the78mole/mppt-2420-hc/kicad/can.kicad_sch

## KiCad design kicad/can.kicad_sch (2025-12-03)

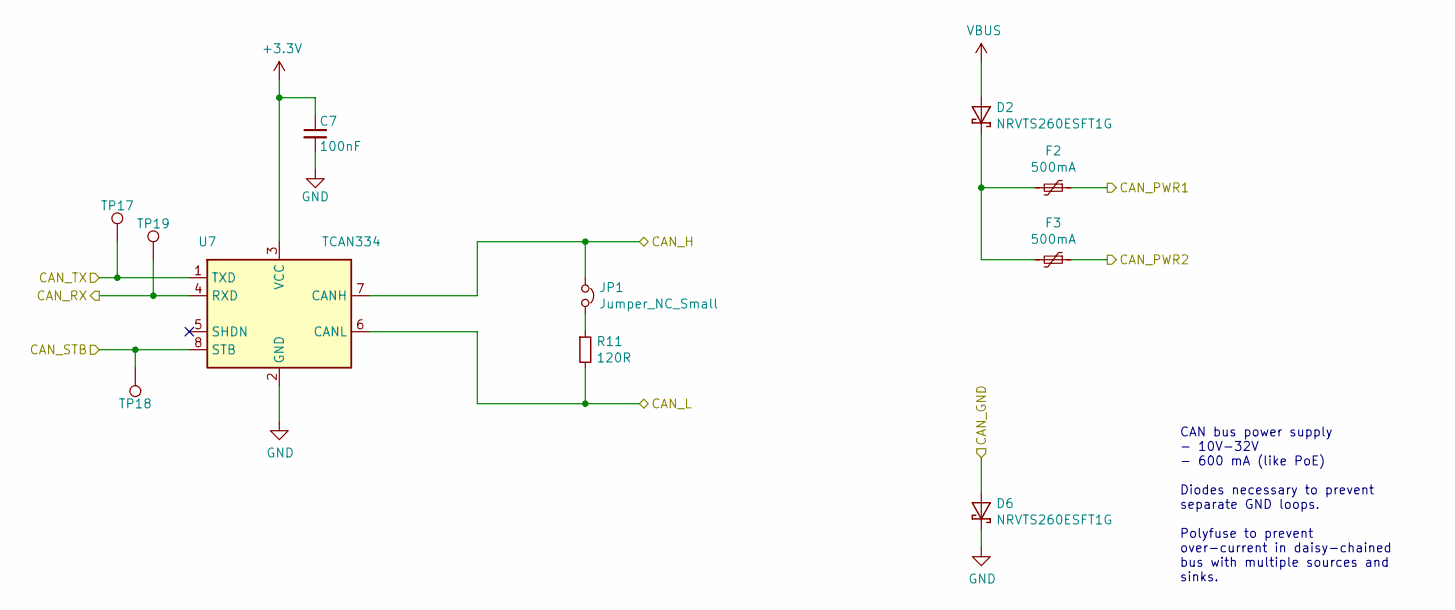
[picture p1: schematic can.kicad_sch]

Parts:
C7: 100nF; C_0603_1608
D2, D6: NRVTS260ESFT1G; D_SOD-123; PartNumber NRVTS260ESFT1G
F2, F3: 500mA; Fuse_1206_3216Metric; PartNumber 0ZCJ0050AF2E
JP1: Jumper_NC_Small; PinHeader_1x02_P2.54mm_Vertical
R11: 120R; R_1206_3216
TP17, TP18, TP19: 1.5mm; TestPoint_Pad_D1.5mm
U7: TCAN334; SOIC-8_3.9x4.9mm_Pitch1.27mm; PartNumber TCAN334DR

Connections:
+3.3V: C7.1, U7.3 (VCC)
CAN_GND: D6.2 (A)
CAN_H: JP1.1, U7.7 (CANH)
CAN_L: R11.2, U7.6 (CANL)
CAN_PWR1: F2.1
CAN_PWR2: F3.1
CAN_RX: TP19.1, U7.4 (RXD)
CAN_STB: TP18.1, U7.8 (STB)
CAN_TX: TP17.1, U7.1 (TXD)
GND: C7.2, D6.1 (K), U7.2 (GND)
unnamed: D2.1 (K), F2.2, F3.2
unnamed: JP1.2, R11.1
VBUS: D2.2 (A)

Notes on the sheet:
CAN bus power supply - 10V-32V - 600 mA (like PoE) Diodes necessary to prevent separate GND loops. Polyfuse to prevent over-current in daisy-chained bus with multiple sources and sinks.
