the78mole/mppt-2420-hc/kicad/dcdc.kicad_sch

## KiCad design kicad/dcdc.kicad_sch (2025-12-03)

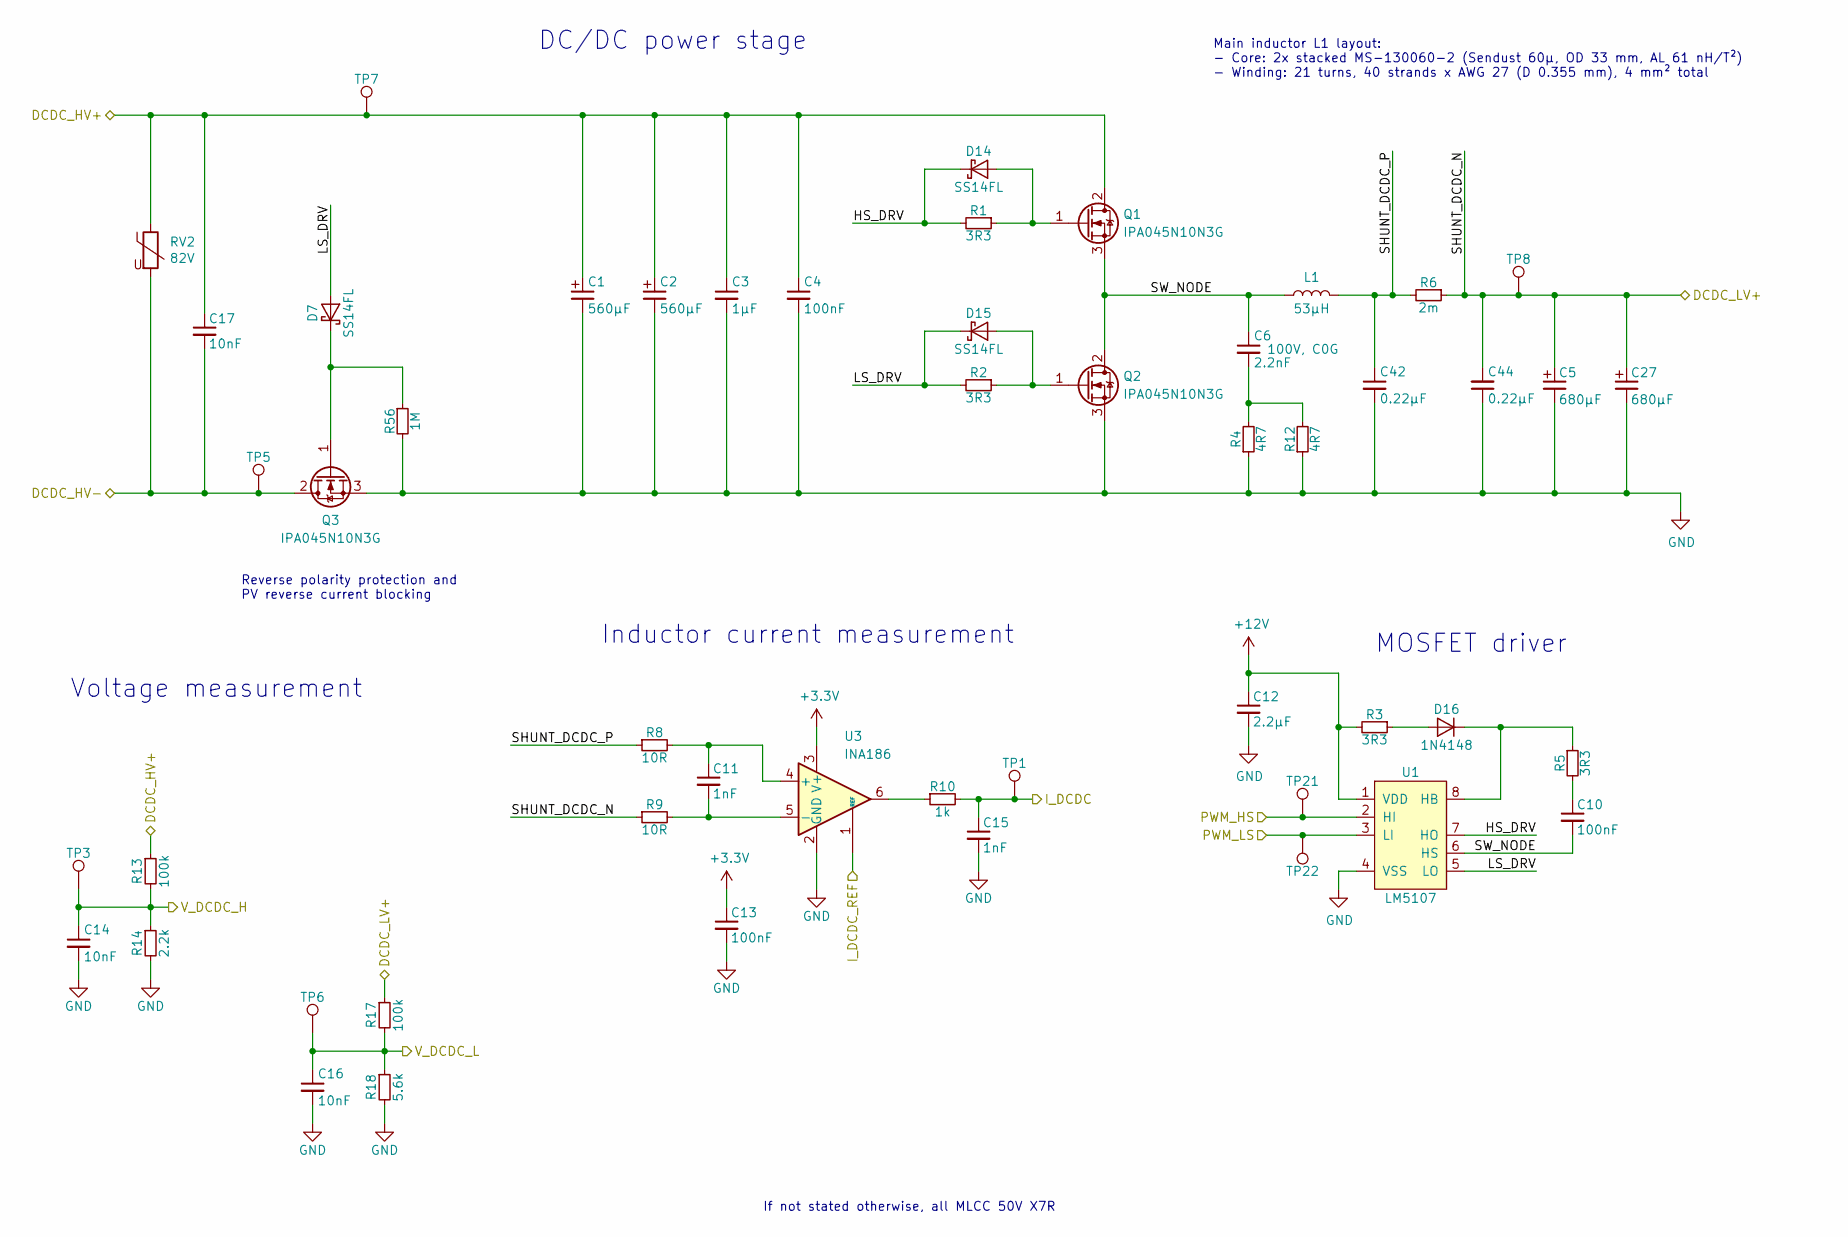
[picture p2: schematic dcdc.kicad_sch]

Parts:
C1, C2: 560µF; CP_Radial_D18.0mm_P7.50mm; PartNumber EKZN101ELL561MM25S
C3: 1µF; C_0805_2012
C4: 100nF; C_0805_2012
C5, C27: 680µF; CP_Radial_D10.0mm_P5.00mm; PartNumber EEU-FR1V681
C6: 2.2nF; C_0603_1608
C10, C13: 100nF; C_0603_1608
C11, C15: 1nF; C_0603_1608
C12: 2.2µF; C_0603_1608
C14, C16, C17: 10nF; C_0603_1608
C42, C44: 0.22µF; C_Rect_L7.2mm_W3.5mm_P5.00mm_FKS2_FKP2_MKS2_MKP2; PartNumber B32529C224J
D7, D14, D15: SS14FL; D_SOD-123; PartNumber SS14FL
D16: 1N4148; D_SOD-123; PartNumber 1N4148W-7-F
L1: 53µH; Inductor_Toroid_D32.8mm_4mm2
Q1, Q2, Q3: IPA045N10N3G; TO-220-3_Horizontal_BottomHeatsink; PartNumber IPA045N10N3G
R1, R2, R3, R5: 3R3; R_0805_2012; PartNumber RC0805FR-073R3L
R4, R12: 4R7; R_1206_3216; PartNumber RC1206FR-074R7L
R6: 2m; R_Bourns_CRE2512; PartNumber CRE2512-FZ-R002E-3
R8, R9: 10R; R_0603_1608
R10: 1k; R_0603_1608
R13, R17: 100k; R_0603_1608
R14: 2.2k; R_0603_1608
R18: 5.6k; R_0603_1608
R56: 1M; R_0603_1608
RV2: 82V; RV_Disc_D12mm_W4.3mm_P7.5mm; PartNumber MOV-10D820K
TP1, TP3, TP5, TP6, TP7, TP8, TP21, TP22: 1.5mm; TestPoint_Pad_D1.5mm
U1: LM5107; SOIC-8_3.9x4.9mm_Pitch1.27mm; PartNumber LM5107MAX/NOPB
U3: INA186; SOT-363_SC-70-6; PartNumber INA186A1IDCKR

Connections:
+3.3V: C13.1, U3.3 (V+)
+12V: C12.1, R3.2, U1.1 (VDD)
DCDC_HV+: C1.1, C2.1, C3.1, C4.1, C17.1, Q1.2 (D), R13.1, RV2.1, TP7.1
DCDC_HV-: C17.2, Q3.2 (D), RV2.2, TP5.1
DCDC_LV+: C5.1, C27.1, C44.2, R6.1, R9.1, R17.1, TP8.1
GND: C1.2, C2.2, C3.2, C4.2, C5.2, C12.2, C13.2, C14.2, C15.2, C16.2, C27.2, C42.2, C44.1, Q2.3 (S), Q3.3 (S), R4.1, R12.1, R14.2, R18.2, R56.2, U1.4 (VSS), U3.2 (GND)
HS_DRV: D14.1 (K), R1.2, U1.7 (HO)
I_DCDC: C15.1, R10.2, TP1.1
I_DCDC_REF: U3.1 (REF)
LS_DRV: D7.2 (A), D15.1 (K), R2.2, U1.5 (LO)
unnamed: C6.2, R4.2, R12.2
unnamed: C10.1, R5.2
unnamed: C11.1, R8.2, U3.4 (+)
unnamed: C11.2, R9.2, U3.5 (-)
unnamed: D7.1 (K), Q3.1 (G), R56.1
unnamed: D14.2 (A), Q1.1 (G), R1.1
unnamed: D15.2 (A), Q2.1 (G), R2.1
unnamed: D16.1 (K), R5.1, U1.8 (HB)
unnamed: D16.2 (A), R3.1
unnamed: R10.1, U3.6
PWM_HS: TP21.1, U1.2 (HI)
PWM_LS: TP22.1, U1.3 (LI)
SHUNT_DCDC_P: C42.1, L1.2, R6.2, R8.1
SW_NODE: C6.1, C10.2, L1.1, Q1.3 (S), Q2.2 (D), U1.6 (HS)
V_DCDC_H: C14.1, R13.2, R14.1, TP3.1
V_DCDC_L: C16.1, R17.2, R18.1, TP6.1

Notes on the sheet:
Main inductor L1 layout: - Core: 2x stacked MS-130060-2 (Sendust 60µ, OD 33 mm, AL 61 nH/T²) - Winding: 21 turns, 40 strands x AWG 27 (D 0.355 mm), 4 mm² total
Reverse polarity protection and PV reverse current blocking
Inductor current measurement
Voltage measurement
MOSFET driver
If not stated otherwise, all MLCC 50V X7R
DC/DC power stage
