the78mole/mppt-2420-hc/kicad/load-switch.kicad_sch

## KiCad design kicad/load-switch.kicad_sch (2025-12-03)

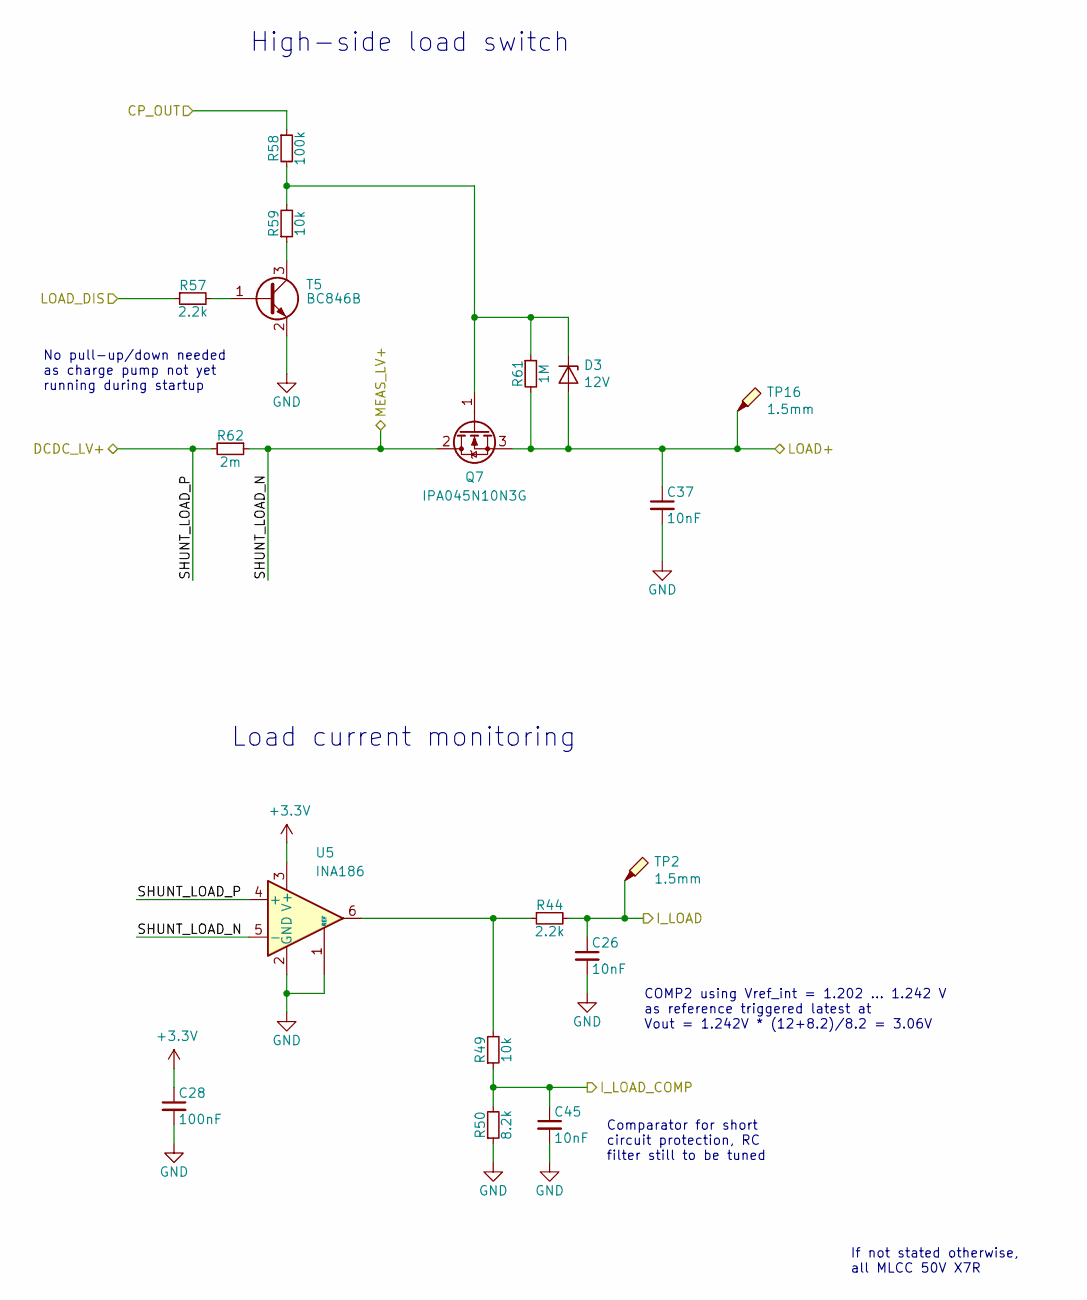
[picture p3: schematic load-switch.kicad_sch]

Parts:
C26, C37, C45: 10nF; C_0603_1608
C28: 100nF; C_0603_1608
D3: 12V; D_SOT-23_ANK; PartNumber SZBZX84C12LT3G
Q7: IPA045N10N3G; TO-220-3_Horizontal_BottomHeatsink; PartNumber IPA045N10N3G
R44, R57: 2.2k; R_0603_1608
R49, R59: 10k; R_0603_1608
R50: 8.2k; C_0603_1608
R58: 100k; R_0603_1608
R61: 1M; R_0603_1608
R62: 2m; R_Bourns_CRE2512; PartNumber CRE2512-FZ-R002E-3
T5: BC846B; SOT-23; PartNumber BC846BLT1G
TP2, TP16: 1.5mm; TestPoint_Pad_D1.5mm
U5: INA186; SOT-363_SC-70-6; PartNumber INA186A1IDCKR

Connections:
+3.3V: C28.1, U5.3 (V+)
CP_OUT: R58.1
DCDC_LV+: R62.2, U5.4 (+)
GND: C26.2, C28.2, C37.2, C45.2, R50.1, T5.2 (E), U5.1 (REF), U5.2 (GND)
I_LOAD: C26.1, R44.2, TP2.1
I_LOAD_COMP: C45.1, R49.1, R50.2
LOAD+: C37.1, D3.2 (A), Q7.3 (S), R61.2, TP16.1
LOAD_DIS: R57.1
MEAS_LV+: Q7.2 (D), R62.1, U5.5 (-)
unnamed: D3.1 (K), Q7.1 (G), R58.2, R59.2, R61.1
unnamed: R44.1, R49.2, U5.6
unnamed: R57.2, T5.1 (B)
unnamed: R59.1, T5.3 (C)

Notes on the sheet:
Comparator for short circuit protection, RC filter still to be tuned
Load current monitoring
No pull-up/down needed as charge pump not yet running during startup
High-side load switch
COMP2 using Vref_int = 1.202 ... 1.242 V as reference triggered latest at Vout = 1.242V * (12+8.2)/8.2 = 3.06V
If not stated otherwise, all MLCC 50V X7R
