the78mole/mppt-2420-hc/kicad/mcu.kicad_sch

## KiCad design kicad/mcu.kicad_sch (2025-12-03)

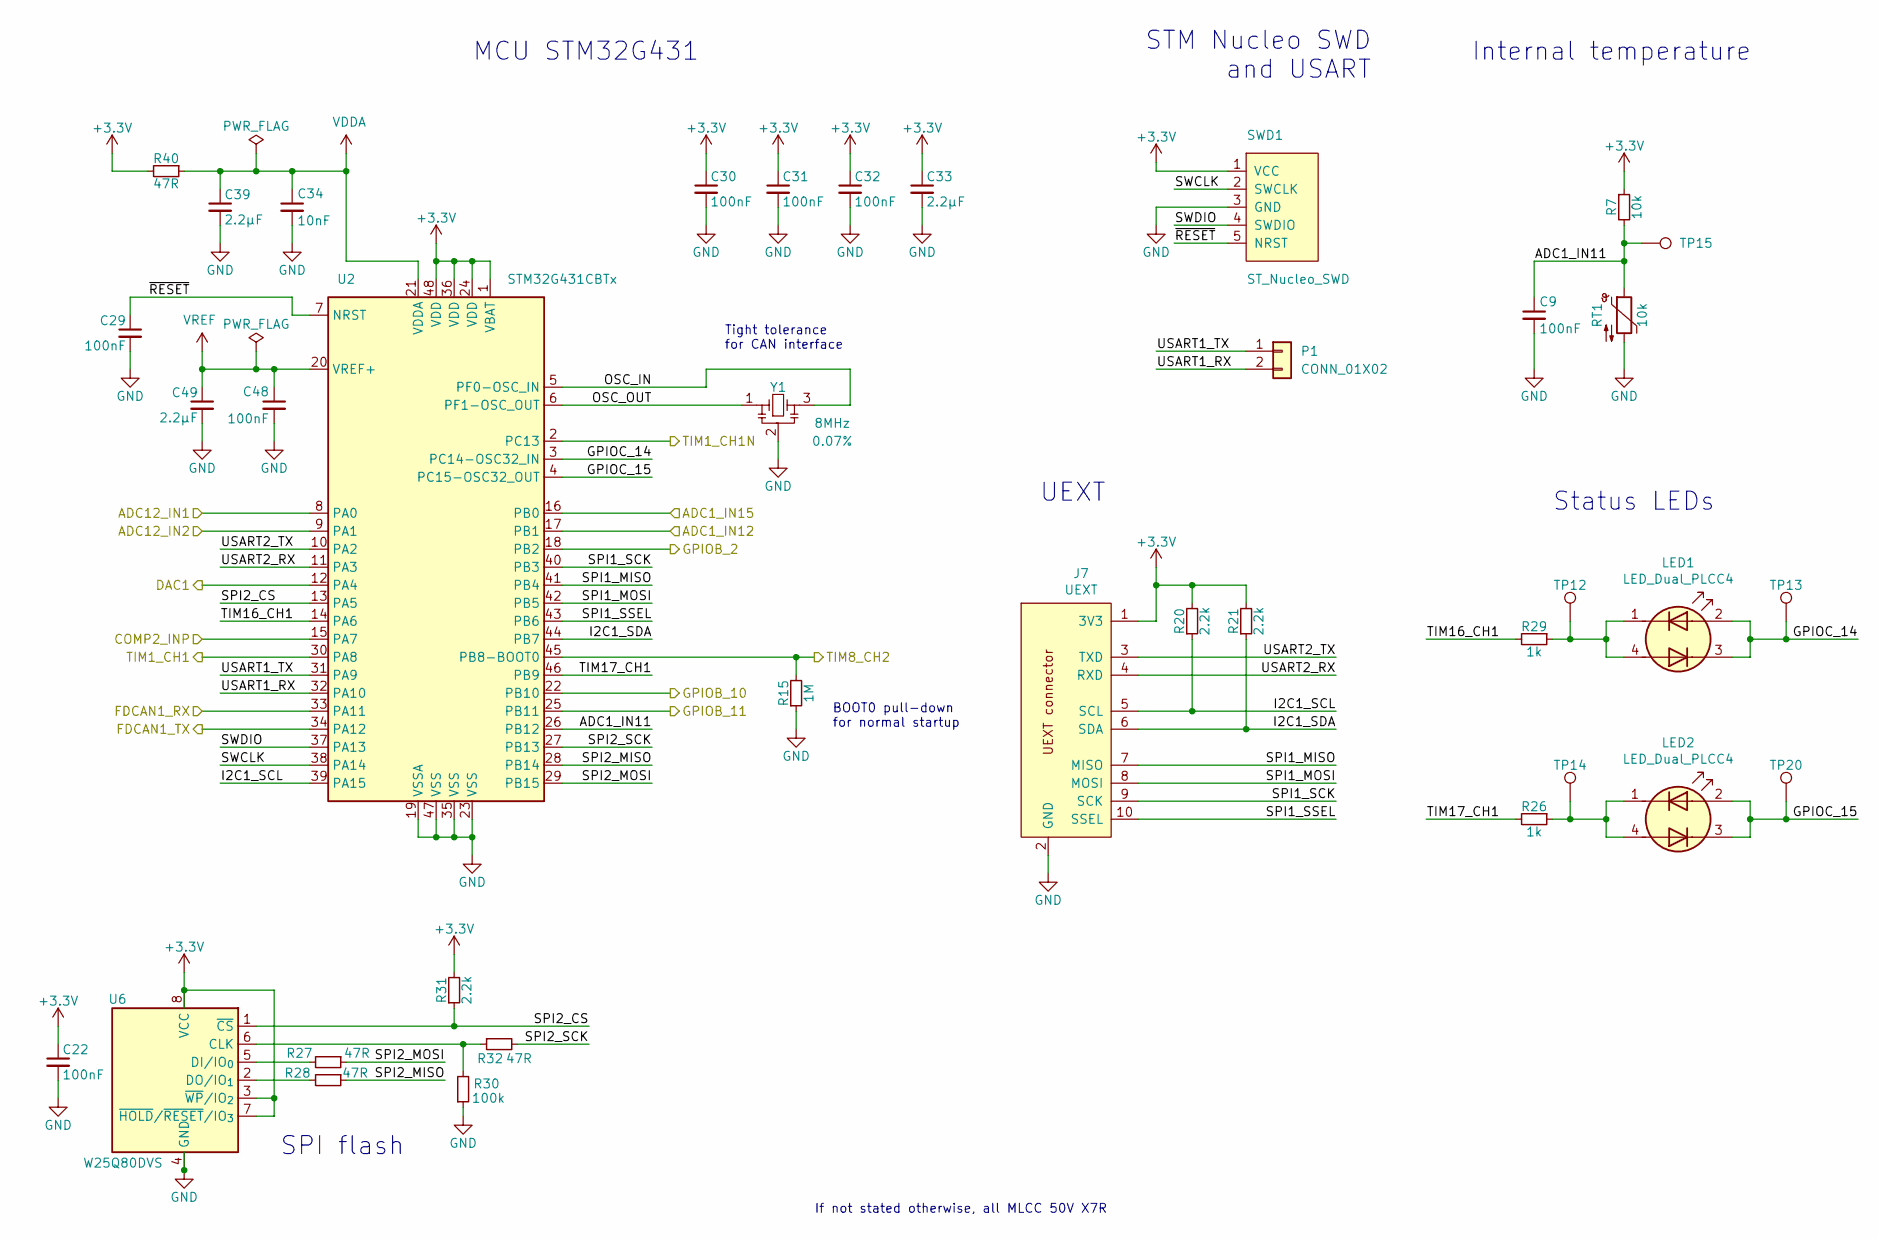
[picture p4: schematic mcu.kicad_sch]

Parts:
C9, C22, C29, C30, C31, C32, C48: 100nF; C_0603_1608
C33, C39, C49: 2.2µF; C_0603_1608
C34: 10nF; C_0603_1608
J7: UEXT; Box_Header_2x05x2.54mm_Straight; PartNumber Box header 2x5, 2.54mm pitch
LED1, LED2: LED_Dual_PLCC4; LED_Avago_PLCC4_3.2x2.8mm_CW; PartNumber LTST-E682KRKGWT
P1: CONN_01X02; PinHeader_1x02_P2.54mm_Vertical; PartNumber Pin header 1x5, 2.54mm pitch
R7: 10k; R_0603_1608
R15: 1M; R_0603_1608
R20, R21, R31: 2.2k; R_0603_1608
R26, R29: 1k; R_0603_1608
R27, R28, R32, R40: 47R; R_0603_1608
R30: 100k; R_0603_1608
RT1: 10k; C_Disc_D3.8mm_W2.6mm_P2.50mm; PartNumber NTCG163JF103FT1S
SWD1: ST_Nucleo_SWD; PinHeader_1x05_P2.54mm_Vertical; PartNumber Pin header 1x5, 2.54mm pitch
TP12, TP13, TP14, TP15, TP20: 1.5mm; TestPoint_Pad_D1.5mm
U2: STM32G431CBTx; LQFP-48_7x7mm_P0.5mm; PartNumber STM32G431CBT6
U6: W25Q80DVS; SOIC-8_3.9x4.9mm_Pitch1.27mm; PartNumber W25Q80DVSNIG
Y1: 8MHz; Resonator_Murata_CSTNE; PartNumber CSTNE8M00GH5C000R0

Connections:
+3.3V: C22.1, C30.1, C31.1, C32.1, C33.1, J7.1 (3V3), R7.1, R20.2, R21.2, R31.2, R40.2, SWD1.1 (VCC), U2.1 (VBAT), U2.24 (VDD), U2.36 (VDD), U2.48 (VDD), U6.3 (~WP/IO_{2}), U6.7 (~HOLD/~RESET/IO_{3}), U6.8 (VCC)
ADC1_IN11: C9.1, R7.2, RT1.1, TP15.1, U2.26 (PB12)
ADC1_IN12: U2.17 (PB1)
ADC1_IN15: U2.16 (PB0)
ADC12_IN1: U2.8 (PA0)
ADC12_IN2: U2.9 (PA1)
COMP2_INP: U2.15 (PA7)
DAC1: U2.12 (PA4)
FDCAN1_RX: U2.33 (PA11)
FDCAN1_TX: U2.34 (PA12)
GND: C9.2, C22.2, C29.2, C30.2, C31.2, C32.2, C33.2, C34.2, C39.2, C48.2, C49.2, J7.2 (GND), R15.1, R30.1, RT1.2, SWD1.3 (GND), U2.19 (VSSA), U2.23 (VSS), U2.35 (VSS), U2.47 (VSS), U6.4 (GND), Y1.2
GPIOB_2: U2.18 (PB2)
GPIOB_10: U2.22 (PB10)
GPIOB_11: U2.25 (PB11)
GPIOC_14: LED1.2 (K1), LED1.3 (A2), TP13.1, U2.3 (PC14-OSC32_IN)
GPIOC_15: LED2.2 (K1), LED2.3 (A2), TP20.1, U2.4 (PC15-OSC32_OUT)
I2C1_SCL: J7.5 (SCL), R20.1, U2.39 (PA15)
I2C1_SDA: J7.6 (SDA), R21.1, U2.44 (PB7)
unnamed: LED1.1 (A1), LED1.4 (K2), R29.1, TP12.1
unnamed: LED2.1 (A1), LED2.4 (K2), R26.1, TP14.1
unnamed: R27.2, U6.5 (DI/IO_{0})
unnamed: R28.2, U6.2 (DO/IO_{1})
unnamed: R30.2, R32.1, U6.6 (CLK)
OSC_IN: U2.5 (PF0-OSC_IN), Y1.3
OSC_OUT: U2.6 (PF1-OSC_OUT), Y1.1
SPI1_MISO: J7.7 (MISO), U2.41 (PB4)
SPI1_MOSI: J7.8 (MOSI), U2.42 (PB5)
SPI1_SCK: J7.9 (SCK), U2.40 (PB3)
SPI1_SSEL: J7.10 (SSEL), U2.43 (PB6)
SPI2_CS: R31.1, U2.13 (PA5), U6.1 (~CS)
SPI2_MISO: R28.1, U2.28 (PB14)
SPI2_MOSI: R27.1, U2.29 (PB15)
SPI2_SCK: R32.2, U2.27 (PB13)
SWCLK: SWD1.2 (SWCLK), U2.38 (PA14)
SWDIO: SWD1.4 (SWDIO), U2.37 (PA13)
TIM1_CH1: U2.30 (PA8)
TIM1_CH1N: U2.2 (PC13)
TIM8_CH2: R15.2, U2.45 (PB8-BOOT0)
TIM16_CH1: R29.2, U2.14 (PA6)
TIM17_CH1: R26.2, U2.46 (PB9)
USART1_RX: P1.2, U2.32 (PA10)
USART1_TX: P1.1, U2.31 (PA9)
USART2_RX: J7.4 (RXD), U2.11 (PA3)
USART2_TX: J7.3 (TXD), U2.10 (PA2)
VDDA: C34.1, C39.1, R40.1, U2.21 (VDDA)
VREF: C48.1, C49.1, U2.20 (VREF+)
~RESET: C29.1, SWD1.5 (NRST), U2.7 (NRST)

Notes on the sheet:
MCU STM32G431
BOOT0 pull-down for normal startup
Tight tolerance for CAN interface
UEXT
SPI flash
If not stated otherwise, all MLCC 50V X7R
Status LEDs
Internal temperature
STM Nucleo SWD and USART
