the78mole/mppt-2420-hc/kicad/mppt-2420-hc.kicad_sch

## KiCad design kicad/mppt-2420-hc.kicad_sch (2025-12-03)

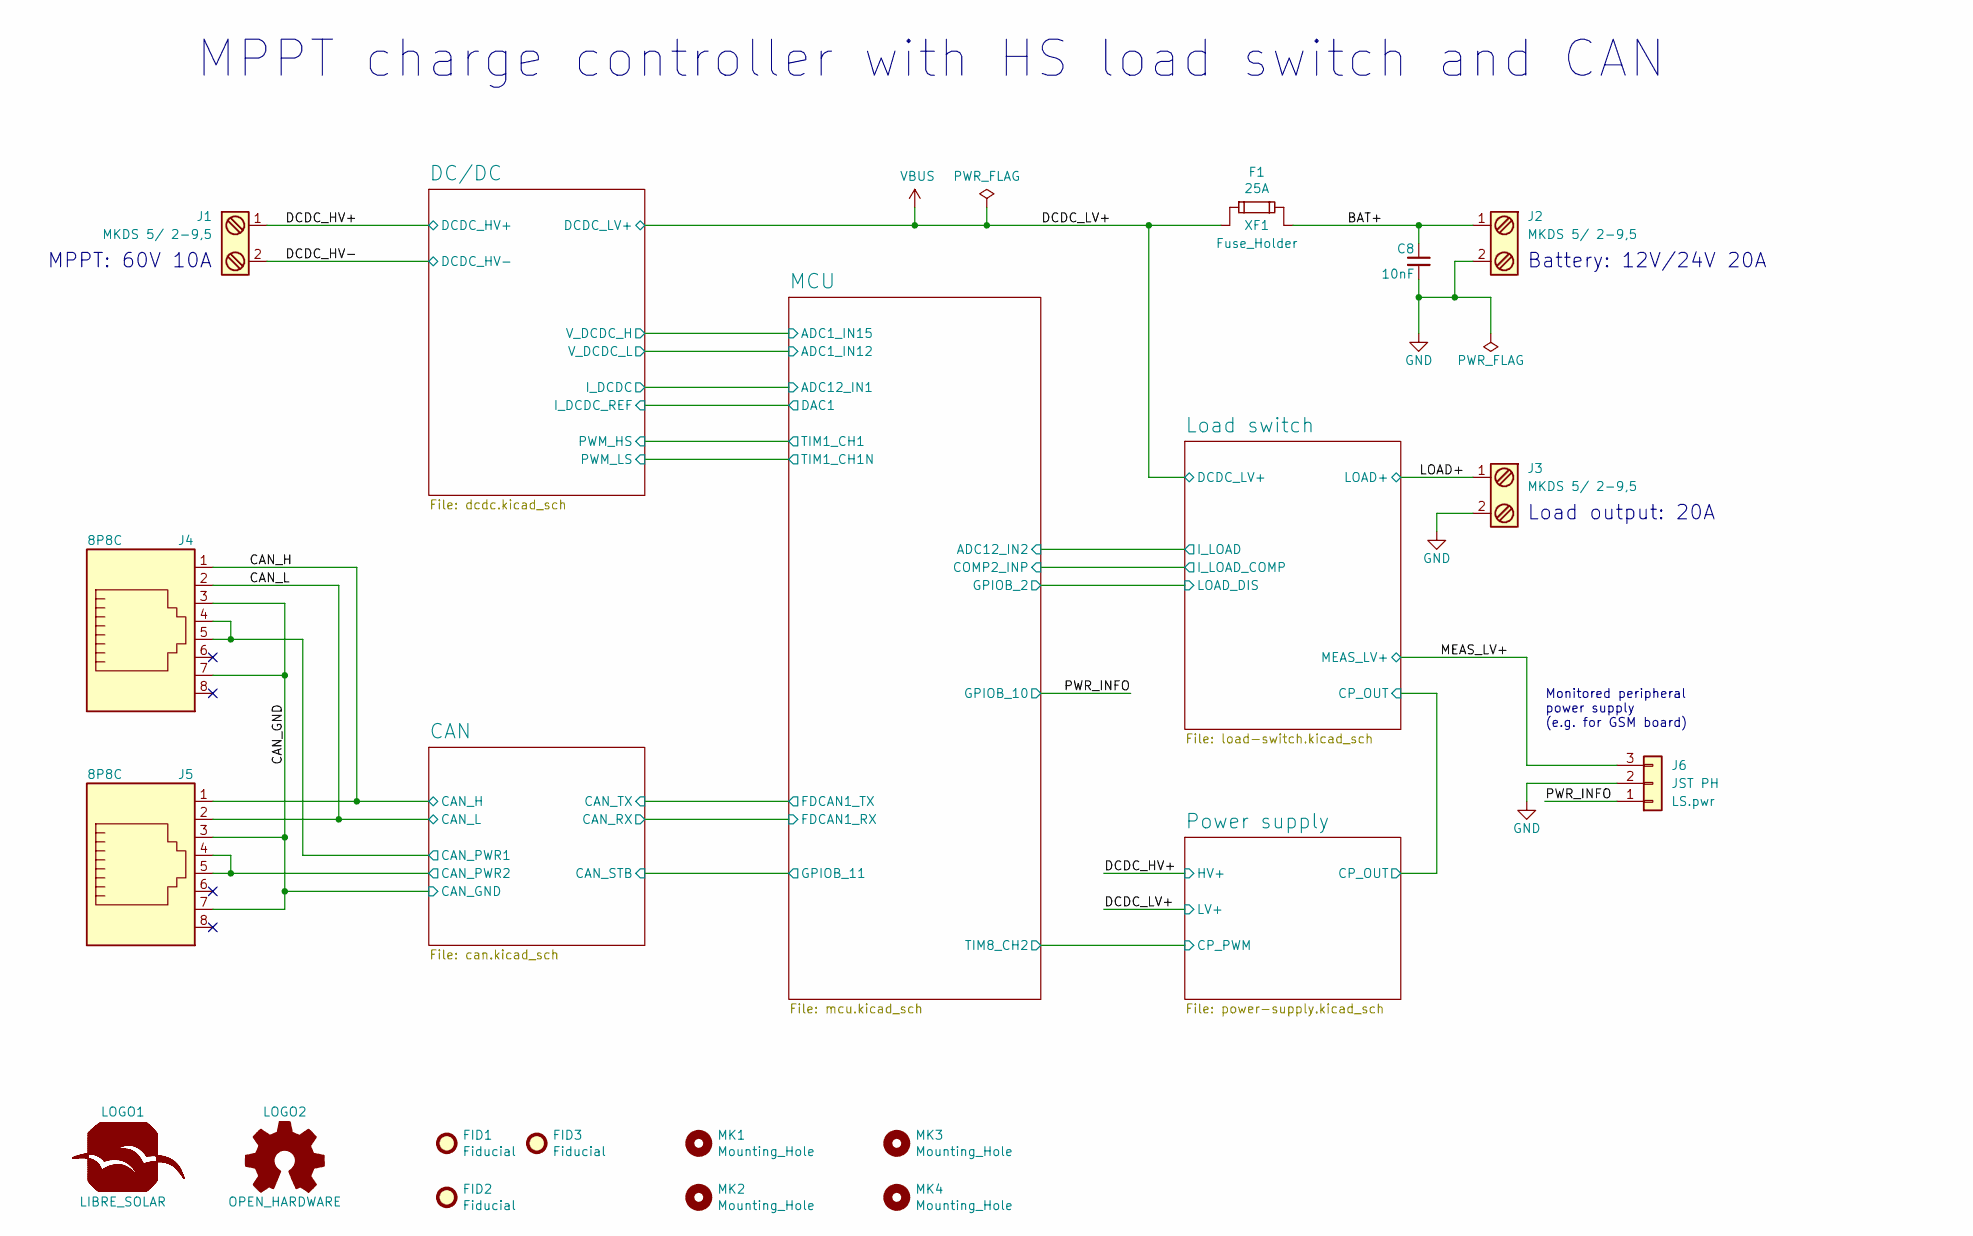
[picture p5: schematic mppt-2420-hc.kicad_sch]

Parts:
C8: 10nF; C_0603_1608
F1: 25A; NULL; PartNumber 0287025.PXCN
FID1, FID2, FID3: Fiducial; Fiducial_0.7mm
J1, J2, J3: MKDS 5/ 2-9,5; Phoenix_Contact_MKDS_5-2-9,5; PartNumber 1714971
J4, J5: 8P8C; RJ45_8P8C; PartNumber 54602-908LF
J6: JST PH; JST_PH_B3B-PH-K_1x03_P2.00mm_Vertical; PartNumber PH B3B-PH-K 1x3, pitch 2.0mm
LOGO1: LIBRE_SOLAR; LIBRESOLAR_LOGO
LOGO2: OPEN_HARDWARE; OSHW-Logo_5.7x6mm_SilkScreen
MK1, MK2, MK3, MK4: Mounting_Hole; MountingHole_3.2mm_M3
XF1: Fuse_Holder; Keystone-Fuse-3557-2; PartNumber 3557-2

Connections:
BAT+: C8.1, J2.1, XF1.2
CAN_GND: J4.3, J4.7, J5.3, J5.7
CAN_H: J4.1, J5.1
CAN_L: J4.2, J5.2
CAN_PWR1: J4.4, J4.5
CAN_PWR2: J5.4, J5.5
DCDC_HV+: J1.1
DCDC_HV-: J1.2
GND: C8.2, J2.2, J3.2, J6.2
LOAD+: J3.1
MEAS_LV+: J6.3
PWR_INFO: J6.1
VBUS: XF1.1

Notes on the sheet:
Load output: 20A
MPPT: 60V 10A
MPPT charge controller with HS load switch and CAN
Monitored peripheral power supply (e.g. for GSM board)
Battery: 12V/24V 20A
