the78mole/mppt-2420-hc/kicad/power-supply.kicad_sch

## KiCad design kicad/power-supply.kicad_sch (2025-12-03)

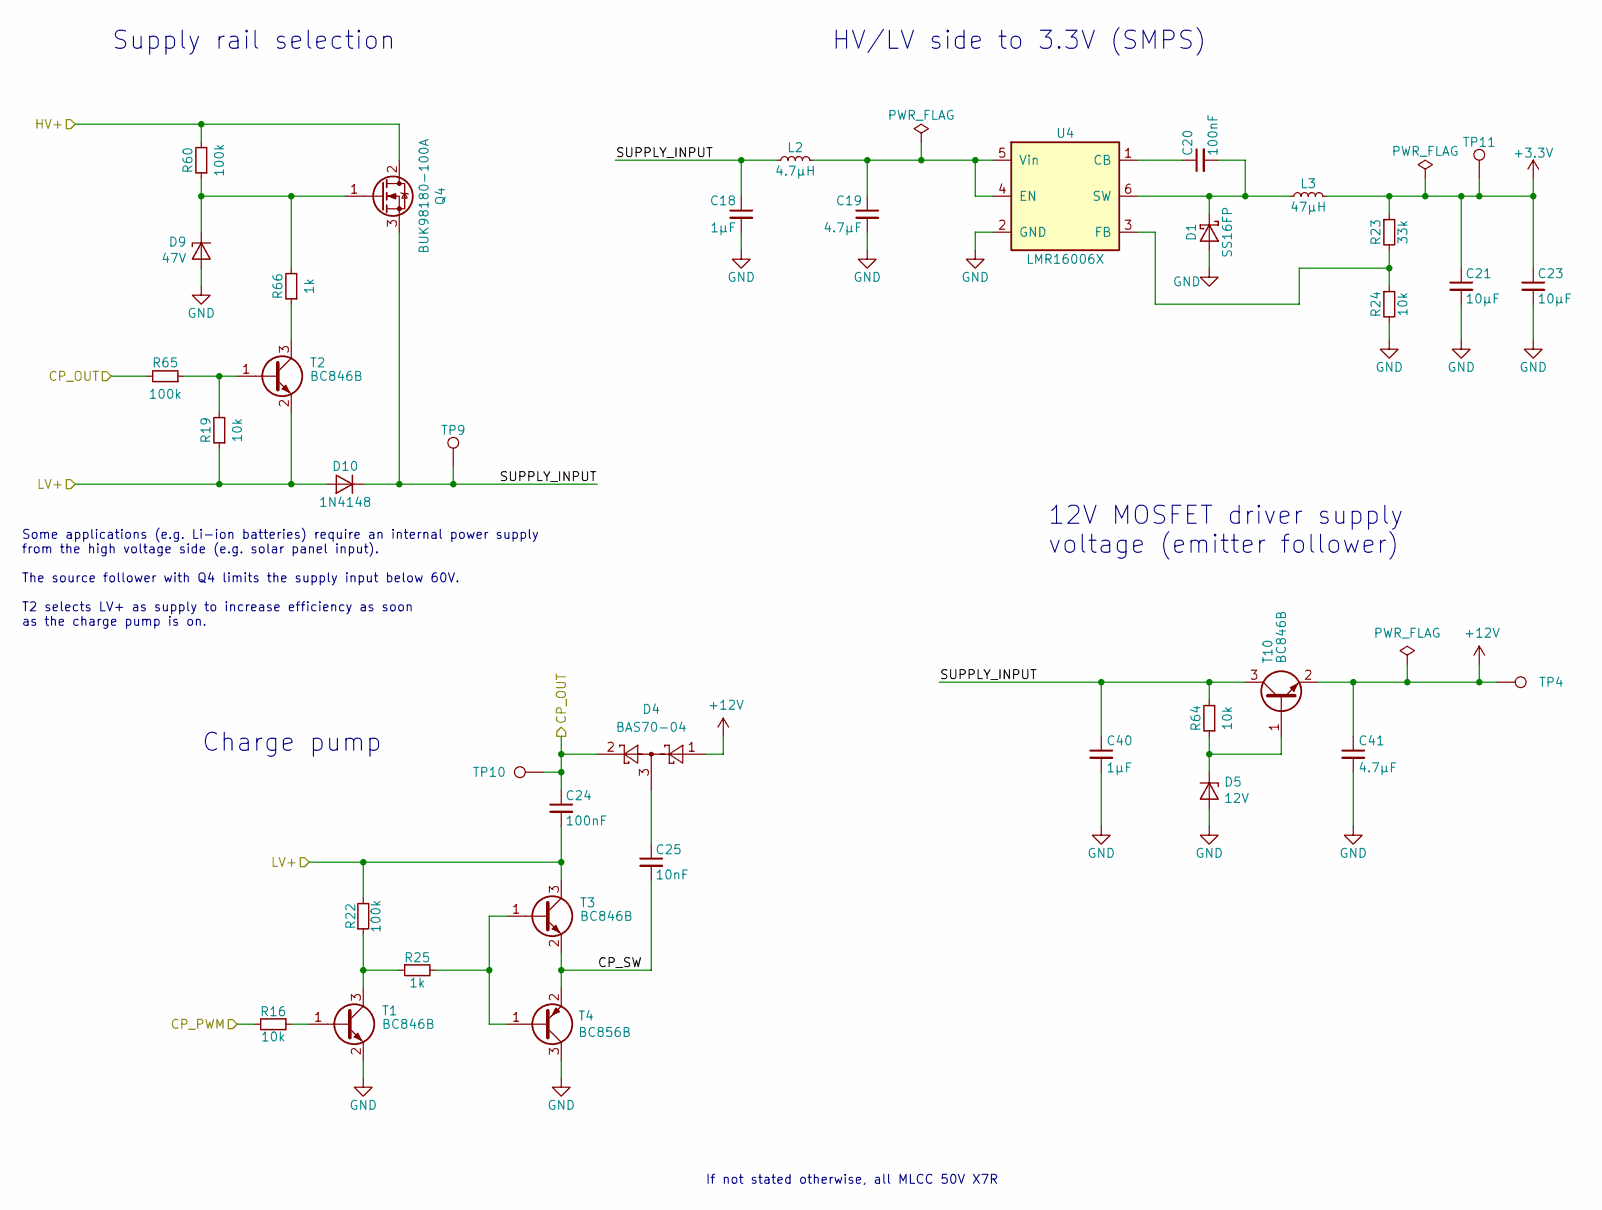
[picture p6: schematic power-supply.kicad_sch]

Parts:
C18: 1µF; C_0805_2012
C19: 4.7µF; C_1210_3225; PartNumber GRJ32DC72A475KE11L
C20, C24: 100nF; C_0603_1608
C21, C23: 10µF; C_0805_2012; PartNumber GRM21BR61E106KA73L
C25: 10nF; C_0603_1608
C40: 1µF; C_0603_1608; PartNumber CC0805KKX7R9BB105
C41: 4.7µF; C_0603_1608; PartNumber 885012107018
D1: SS16FP; D_PowerDI-123; PartNumber SS16FP
D4: BAS70-04; SOT-23; PartNumber BAS70-04LT1G
D5: 12V; D_SOT-23_ANK; PartNumber SZBZX84C12LT3G
D9: 47V; D_SOT-23_ANK; PartNumber SZBZX84C47LT1G
D10: 1N4148; D_SOD-123; PartNumber 1N4148W-7-F
L2: 4.7µH; L_0805_2012Metric; PartNumber LQM21PN4R7NGRD
L3: 47µH; Bourns_SRN6045TA; PartNumber NR6045T470M
Q4: BUK98180-100A; SOT-223-3_TabPin2; PartNumber BUK98180-100A/CUX
R16, R19, R24, R64: 10k; R_0603_1608
R22, R60, R65: 100k; R_0603_1608
R23: 33k; R_0603_1608
R25, R66: 1k; R_0603_1608
T1, T2, T3, T10: BC846B; SOT-23; PartNumber BC846BLT1G
T4: BC856B; SOT-23; PartNumber BC856BLT1G
TP4, TP9, TP10, TP11: 1.5mm; TestPoint_Pad_D1.5mm
U4: LMR16006X; SOT-23-6; PartNumber LMR16006XDDCR

Connections:
+3.3V: C21.1, C23.1, L3.2, R23.1, TP11.1
+12V: C41.1, D4.1, T10.2 (E), TP4.1
CP_OUT: C24.1, D4.2, R65.2, TP10.1
CP_PWM: R16.2
CP_SW: C25.2, T3.2 (E), T4.2 (E)
GND: C18.2, C19.2, C21.2, C23.2, C40.2, C41.2, D1.2 (A), D5.2 (A), D9.2 (A), R24.2, T1.2 (E), T4.3 (C), U4.2 (GND)
HV+: Q4.2 (D), R60.2
LV+: C24.2, D10.2 (A), R19.1, R22.2, T2.2 (E), T3.3 (C)
unnamed: C19.1, L2.2, U4.4 (EN), U4.5 (Vin)
unnamed: C20.1, U4.1 (CB)
unnamed: C20.2, D1.1 (K), L3.1, U4.6 (SW)
unnamed: C25.1, D4.3
unnamed: D5.1 (K), R64.1, T10.1 (B)
unnamed: D9.1 (K), Q4.1 (G), R60.1, R66.2
unnamed: R16.1, T1.1 (B)
unnamed: R19.2, R65.1, T2.1 (B)
unnamed: R22.1, R25.1, T1.3 (C)
unnamed: R23.2, R24.1, U4.3 (FB)
unnamed: R25.2, T3.1 (B), T4.1 (B)
unnamed: R66.1, T2.3 (C)
SUPPLY_INPUT: C18.1, C40.1, D10.1 (K), L2.1, Q4.3 (S), R64.2, T10.3 (C), TP9.1

Notes on the sheet:
Some applications (e.g. Li-ion batteries) require an internal power supply from the high voltage side (e.g. solar panel input). The source follower with Q4 limits the supply input below 60V. T2 selects LV+ as supply to increase efficiency as soon as the charge pump is on.
12V MOSFET driver supply voltage (emitter follower)
Supply rail selection
If not stated otherwise, all MLCC 50V X7R
HV/LV side to 3.3V (SMPS)
Charge pump
