the78mole/mppt-2420-hc/(commit log)

2025-12-03 Update to KiCad 9
    [can.kicad_sch, dcdc.kicad_sch, load-switch.kicad_sch, mcu.kicad_sch, mppt-2420-hc.kicad_sch, power-supply.kicad_sch]
2025-12-03 Corrected MCU schematics, SPI Flash Symbol changed
    [mcu.kicad_sch]
