the78mole/mppt-2420-hc/(notices)

Notices in the files:
kicad/dcdc.kicad_sch:
Copyright © 2020 Libre Solar Technologies GmbH
Licensed under CERN-OHL-W version 2
